BenRufenacht/KosmoKassutronicsQuantizer/QuantizerPanelGraphics.png

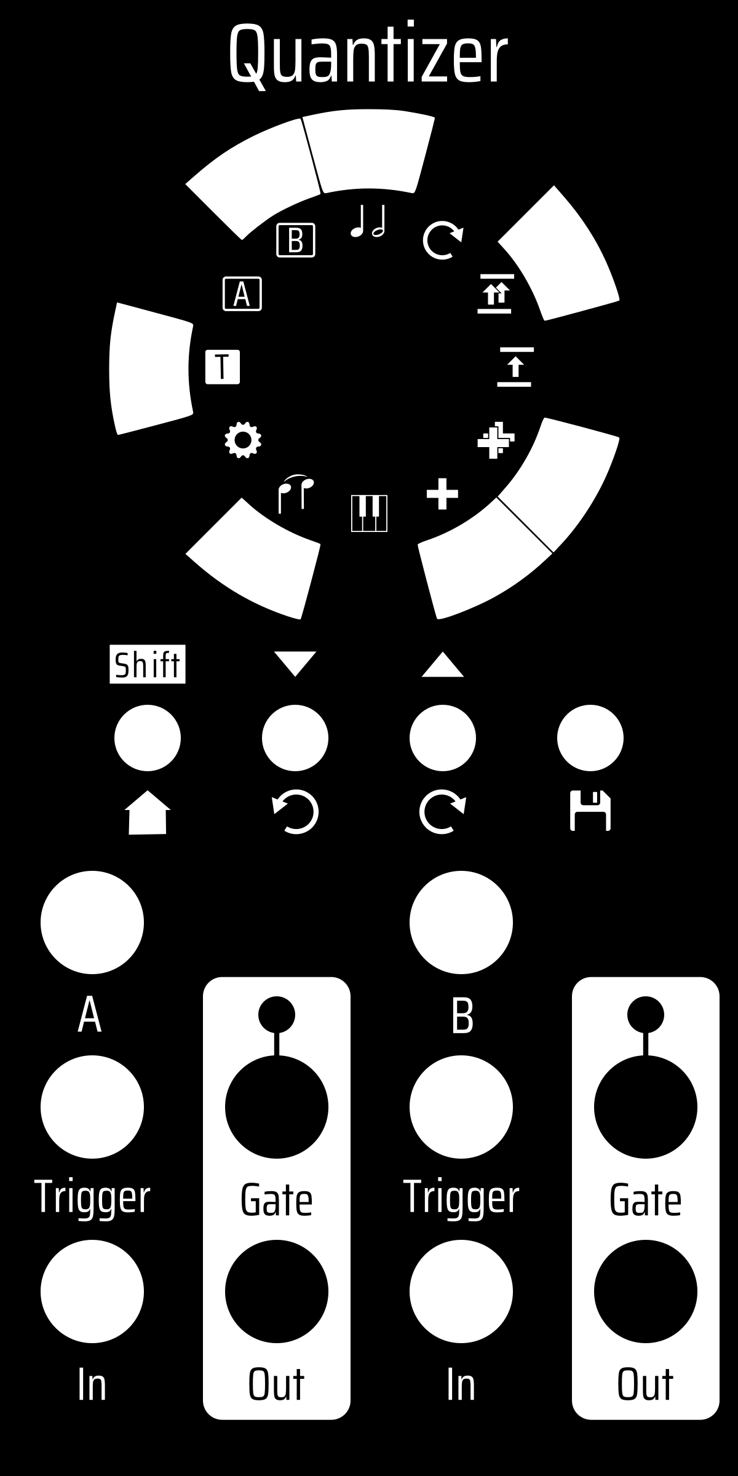
QuantizerPanelGraphics.png
