BenRufenacht/KosmoKassutronicsQuantizer/(list of files, drawings)

Other design files:
QuantizerBack/QuantizerBack.dsn
QuantizerFront/QuantizerFront.dsn
