BenRufenacht/KosmoKassutronicsQuantizer/QuantizerBack/QuantizerBack.kicad_pcb

## KiCad design QuantizerBack/QuantizerBack.kicad_pcb (2023-10-14)

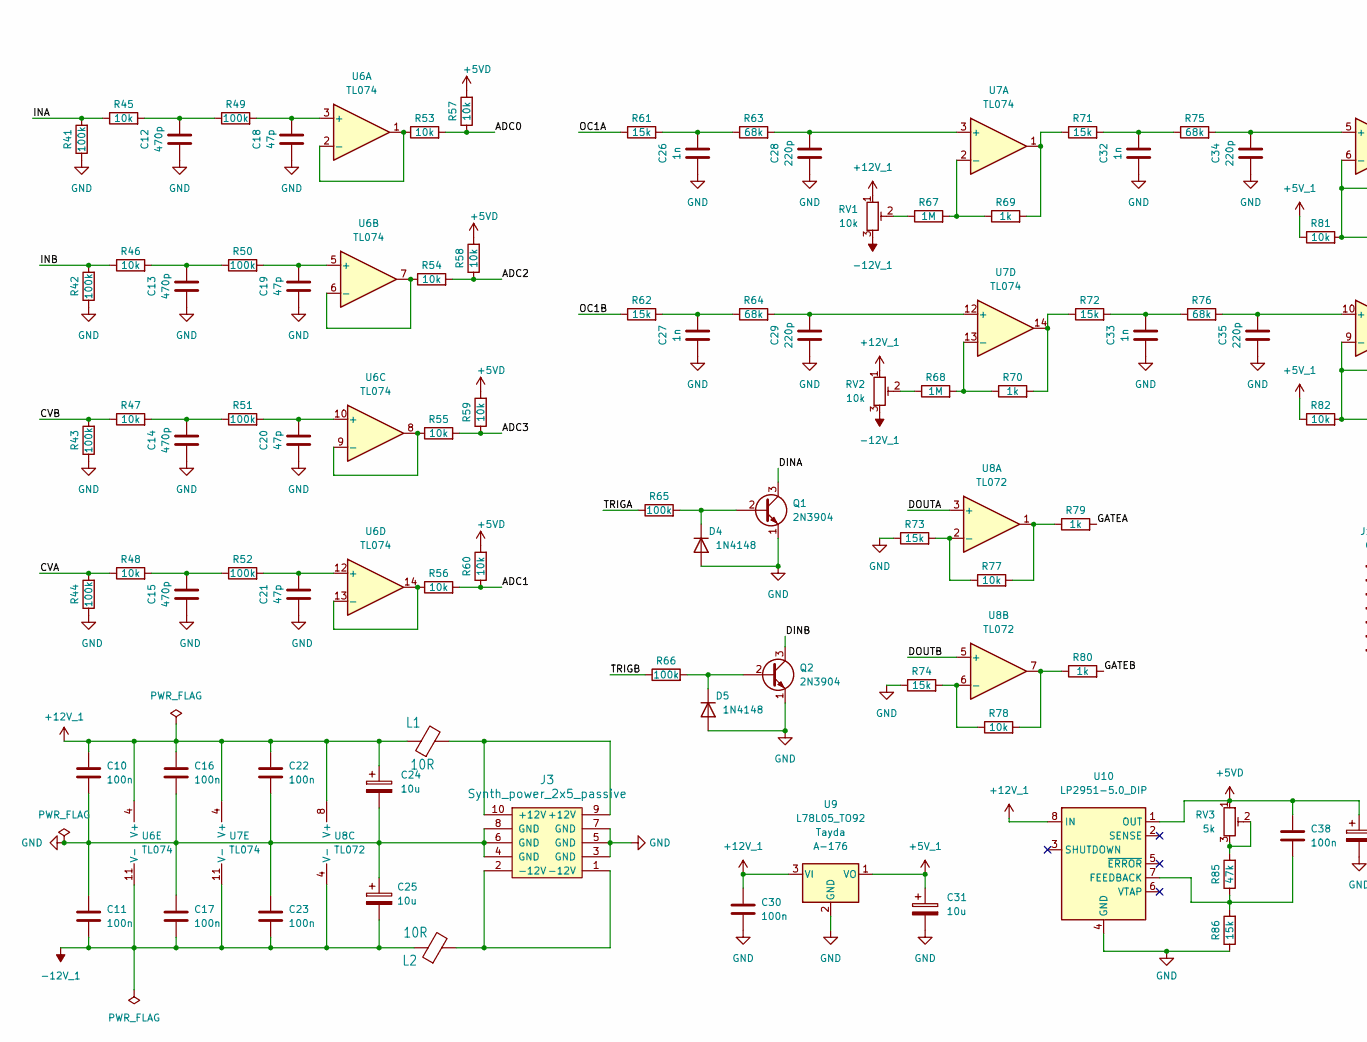
[picture p3: schematic QuantizerBack.kicad_sch, part in row 1, column 1]

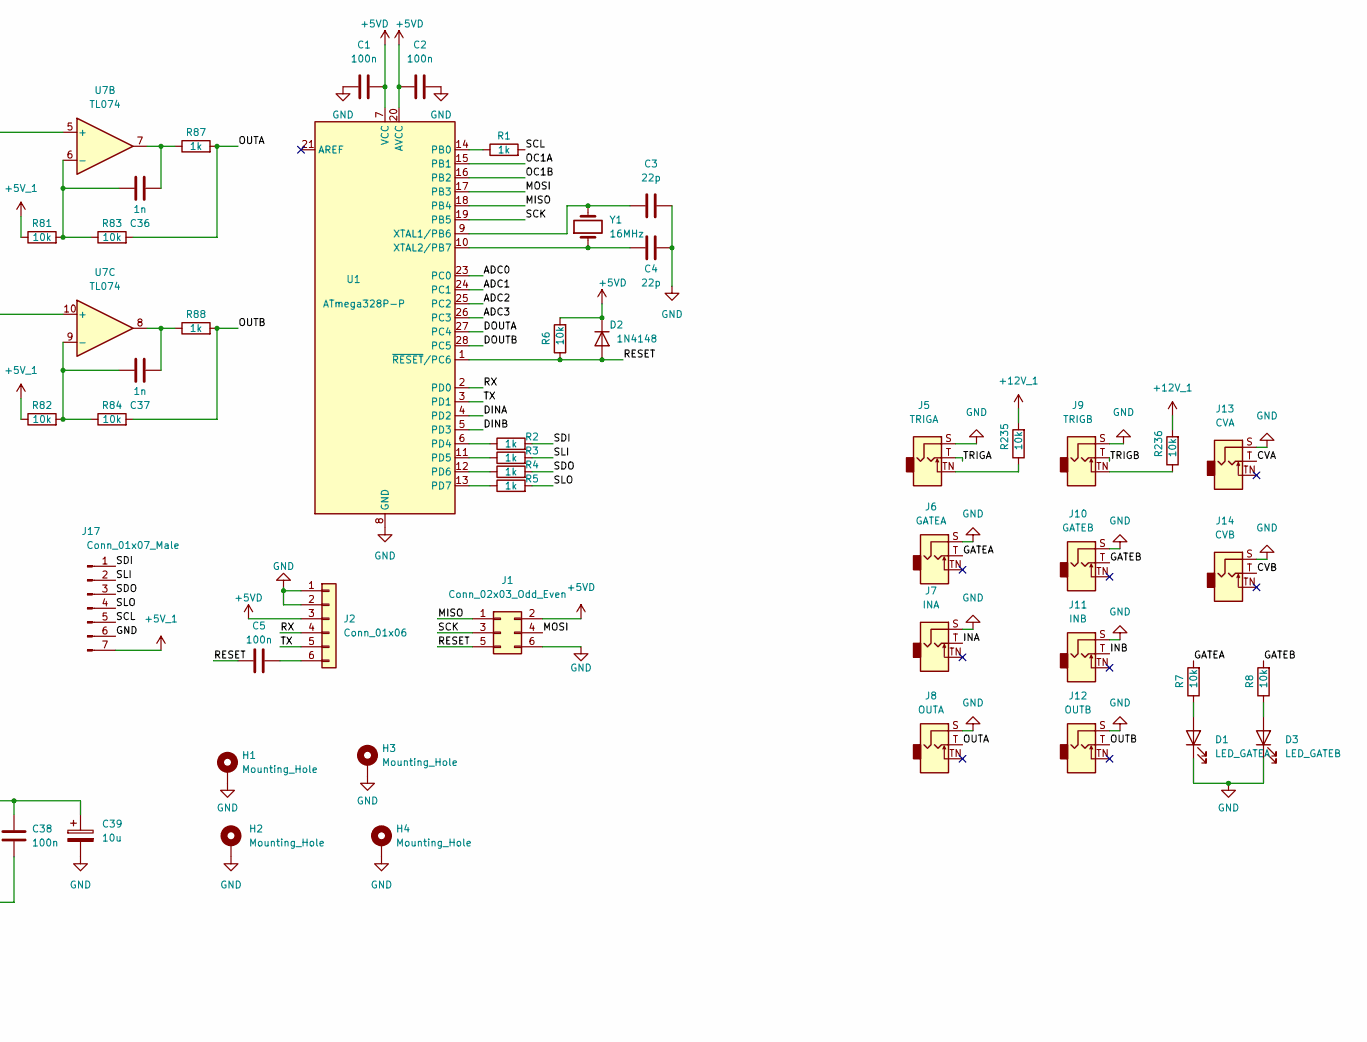
[picture p4: schematic QuantizerBack.kicad_sch, part in row 1, column 2]

Parts:
C1, C2, C5, C10, C11, C16, C17, C22, C23, C30, C38: 100n; C_Rect_L7.2mm_W2.5mm_P5.00mm_FKS2_FKP2_MKS2_MKP2
C3, C4: 22p; C_Rect_L7.2mm_W2.5mm_P5.00mm_FKS2_FKP2_MKS2_MKP2
C12, C13, C14, C15: 470p; C_Rect_L7.2mm_W2.5mm_P5.00mm_FKS2_FKP2_MKS2_MKP2
C18, C19, C20, C21: 47p; C_Rect_L7.2mm_W2.5mm_P5.00mm_FKS2_FKP2_MKS2_MKP2
C24, C25, C31, C39: 10u; CP_Radial_D6.3mm_P2.50mm
C26, C27, C32, C33, C36, C37: 1n; C_Rect_L7.2mm_W2.5mm_P5.00mm_FKS2_FKP2_MKS2_MKP2
C28, C29, C34, C35: 220p; C_Rect_L7.2mm_W2.5mm_P5.00mm_FKS2_FKP2_MKS2_MKP2
D1: LED_GATEA; LED_D5.0mm
D2, D4, D5: 1N4148; D_DO-35_SOD27_P7.62mm_Horizontal
D3: LED_GATEB; LED_D5.0mm
H1, H2, H3, H4: Mounting_Hole; Kosmo_Panel_Mounting_Hole
J1: Conn_02x03_Odd_Even; PinHeader_2x03_P2.54mm_Vertical
J2: Conn_01x06; PinHeader_1x06_P2.54mm_Vertical
J3: Synth_power_2x5_passive; Power_Header
J5: TRIGA; Jack_6.35mm_PJ_629HAN
J6: GATEA; Jack_6.35mm_PJ_629HAN
J7: INA; Jack_6.35mm_PJ_629HAN
J8: OUTA; Jack_6.35mm_PJ_629HAN
J9: TRIGB; Jack_6.35mm_PJ_629HAN
J10: GATEB; Jack_6.35mm_PJ_629HAN
J11: INB; Jack_6.35mm_PJ_629HAN
J12: OUTB; Jack_6.35mm_PJ_629HAN
J13: CVA; Jack_6.35mm_PJ_629HAN
J14: CVB; Jack_6.35mm_PJ_629HAN
J17: Conn_01x07_Male; PinHeader_1x07_P2.54mm_Vertical
L1, L2: 10R; L_Axial_L5.0mm_D3.6mm_P10.00mm_Horizontal_Murata_BL01RN1A2A2
Q1, Q2: 2N3904; TO-92_Inline_Wide
R1, R2, R3, R4, R5, R69, R70, R79, R80, R87, R88: 1k; R_Axial_DIN0207_L6.3mm_D2.5mm_P10.16mm_Horizontal
R6, R7, R8, R45, R46, R47, R48, R53, R54, R55, R56, R57, R58, R59, R60, R77, R78, R81, R82, R83, R84, R235, R236: 10k; R_Axial_DIN0207_L6.3mm_D2.5mm_P10.16mm_Horizontal
R41, R42, R43, R44, R49, R50, R51, R52, R65, R66: 100k; R_Axial_DIN0207_L6.3mm_D2.5mm_P10.16mm_Horizontal
R61, R62, R71, R72, R73, R74, R86: 15k; R_Axial_DIN0207_L6.3mm_D2.5mm_P10.16mm_Horizontal
R63, R64, R75, R76: 68k; R_Axial_DIN0207_L6.3mm_D2.5mm_P10.16mm_Horizontal
R67, R68: 1M; R_Axial_DIN0207_L6.3mm_D2.5mm_P10.16mm_Horizontal
R85: 47k; R_Axial_DIN0207_L6.3mm_D2.5mm_P10.16mm_Horizontal
RV1, RV2: 10k; Potentiometer_Bourns_3296W_Vertical_standard
RV3: 5k; Potentiometer_Bourns_3296W_Vertical_standard
U1: ATmega328P-P; DIP-28_W7.62mm
U6, U7: TL074; DIP-14_W7.62mm_Socket_LongPads
U8: TL072; DIP-8_W7.62mm_Socket_LongPads
U9: L78L05_TO92; TO-92_Inline
U10: LP2951-5.0_DIP; DIP-8_W7.62mm
Y1: 16MHz; Crystal_HC49-U_Vertical

Connections:
+5VD: C1.2, C2.1, C38.1, C39.1, D2.1 (K), J1.2, J2.3, R6.2, R57.2, R58.2, R59.2, R60.2, RV3.1, U1.7 (VCC), U1.20 (AVCC), U10.1 (OUT)
+5V_1: C31.1, J17.7, R81.1, R82.1, U9.1 (VO)
+12V_1: C10.1, C16.1, C22.1, C24.1, C30.1, L1.1, R235.2, R236.2, RV1.1, RV2.1, U6.4 (V+), U7.4 (V+), U8.8 (V+), U9.3 (VI), U10.8 (IN)
-12V_1: C11.1, C17.1, C23.1, C25.2, L2.1, RV1.3, RV2.3, U6.11 (V-), U7.11 (V-), U8.4 (V-)
/ADC0: R53.2, R57.1, U1.23 (PC0)
/ADC1: R56.2, R60.1, U1.24 (PC1)
/ADC2: R54.2, R58.1, U1.25 (PC2)
/ADC3: R55.2, R59.1, U1.26 (PC3)
/CVA: J13.T, R44.2, R48.1
/CVB: J14.T, R43.2, R47.1
/DINA: Q1.3 (C), U1.4 (PD2)
/DINB: Q2.3 (C), U1.5 (PD3)
/DOUTA: U1.27 (PC4), U8.3 (+)
/DOUTB: U1.28 (PC5), U8.5 (+)
/GATEA: J6.T, R7.2, R79.2
/GATEB: J10.T, R8.2, R80.2
/INA: J7.T, R41.2, R45.1
/INB: J11.T, R42.2, R46.1
/MISO: J1.1, U1.18 (PB4)
/MOSI: J1.4, U1.17 (PB3)
/OC1A: R61.1, U1.15 (PB1)
/OC1B: R62.1, U1.16 (PB2)
/OUTA: J8.T, R83.2, R87.2
/OUTB: J12.T, R84.2, R88.2
/RESET: C5.1, D2.2 (A), J1.5, R6.1, U1.1 (~RESET/PC6)
/RX: J2.4, U1.2 (PD0)
/SCK: J1.3, U1.19 (PB5)
/SCL: J17.5, R1.2
/SDI: J17.1, R2.2
/SDO: J17.3, R4.2
/SLI: J17.2, R3.2
/SLO: J17.4, R5.2
/TRIGA: J5.T, R65.1
/TRIGB: J9.T, R66.1
/TX: J2.5, U1.3 (PD1)
GND: C1.1, C2.2, C3.2, C4.2, C10.2, C11.2, C12.1, C13.1, C14.1, C15.1, C16.2, C17.2, C18.1, C19.1, C20.1, C21.1, C22.2, C23.2, C24.2, C25.1, C26.1, C27.1, C28.1, C29.1, C30.2, C31.2, C32.1, C33.1, C34.1, C35.1, C39.2, D1.1 (K), D3.1 (K), D4.2 (A), D5.2 (A), H1.1, H2.1, H3.1, H4.1, J1.6, J2.1, J2.2, J3.3 (GND), J3.4 (GND), J3.5 (GND), J3.6 (GND), J3.7 (GND), J3.8 (GND), J5.S, J6.S, J7.S, J8.S, J9.S, J10.S, J11.S, J12.S, J13.S, J14.S, J17.6, Q1.1 (E), Q2.1 (E), R41.1, R42.1, R43.1, R44.1, R73.1, R74.1, R86.1, U1.8 (GND), U1.22 (GND), U9.2 (GND), U10.4 (GND)
unnamed: C12.2, R45.2, R49.1
unnamed: C13.2, R46.2, R50.1
unnamed: C14.2, R47.2, R51.1
unnamed: C15.2, R48.2, R52.1
unnamed: C26.2, R61.2, R63.1
unnamed: C27.2, R62.2, R64.1
unnamed: C32.2, R71.2, R75.1
unnamed: C33.2, R72.2, R76.1
unnamed: C36.1, R87.1, U7.7
unnamed: C37.1, R88.1, U7.8
unnamed: D1.2 (A), R7.1
unnamed: D3.2 (A), R8.1
unnamed: D4.1 (K), Q1.2 (B), R65.2
unnamed: D5.1 (K), Q2.2 (B), R66.2
unnamed: C5.2, J2.6
unnamed: J3.9 (+12V), J3.10 (+12V), L1.2
unnamed: J3.1 (-12V), J3.2 (-12V), L2.2
unnamed: J5.TN, R235.1
unnamed: J9.TN, R236.1
unnamed: R67.1, RV1.2
unnamed: R68.1, RV2.2
unnamed: R69.2, R71.1, U7.1
unnamed: R70.2, R72.1, U7.14
unnamed: R77.2, R79.1, U8.1
unnamed: R78.2, R80.1, U8.7
unnamed: R85.2, RV3.2, RV3.3
unnamed: R1.1, U1.14 (PB0)
unnamed: R2.1, U1.6 (PD4)
unnamed: R3.1, U1.11 (PD5)
unnamed: R4.1, U1.12 (PD6)
unnamed: R5.1, U1.13 (PD7)
unnamed: C3.1, U1.9 (XTAL1/PB6), Y1.2
unnamed: C4.1, U1.10 (XTAL2/PB7), Y1.1
unnamed: C18.2, R49.2, U6.3 (+)
unnamed: R53.1, U6.1, U6.2 (-)
unnamed: C19.2, R50.2, U6.5 (+)
unnamed: R54.1, U6.6 (-), U6.7
unnamed: C20.2, R51.2, U6.10 (+)
unnamed: R55.1, U6.8, U6.9 (-)
unnamed: C21.2, R52.2, U6.12 (+)
unnamed: R56.1, U6.13 (-), U6.14
unnamed: C28.2, R63.2, U7.3 (+)
unnamed: R67.2, R69.1, U7.2 (-)
unnamed: C34.2, R75.2, U7.5 (+)
unnamed: C36.2, R81.2, R83.1, U7.6 (-)
unnamed: C35.2, R76.2, U7.10 (+)
unnamed: C37.2, R82.2, R84.1, U7.9 (-)
unnamed: C29.2, R64.2, U7.12 (+)
unnamed: R68.2, R70.1, U7.13 (-)
unnamed: R73.2, R77.1, U8.2 (-)
unnamed: R74.2, R78.1, U8.6 (-)
unnamed: C38.2, R85.1, R86.2, U10.7 (FEEDBACK)

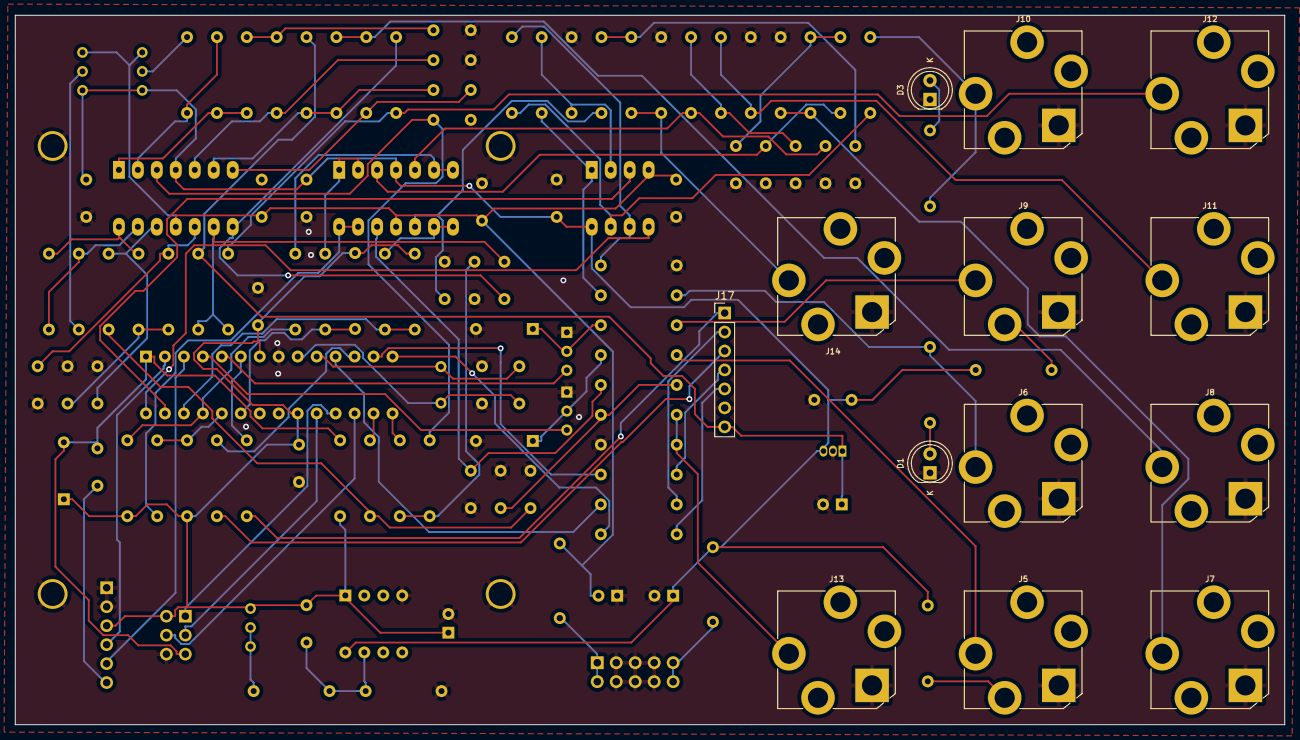
[picture p5: board QuantizerBack.kicad_pcb from above]

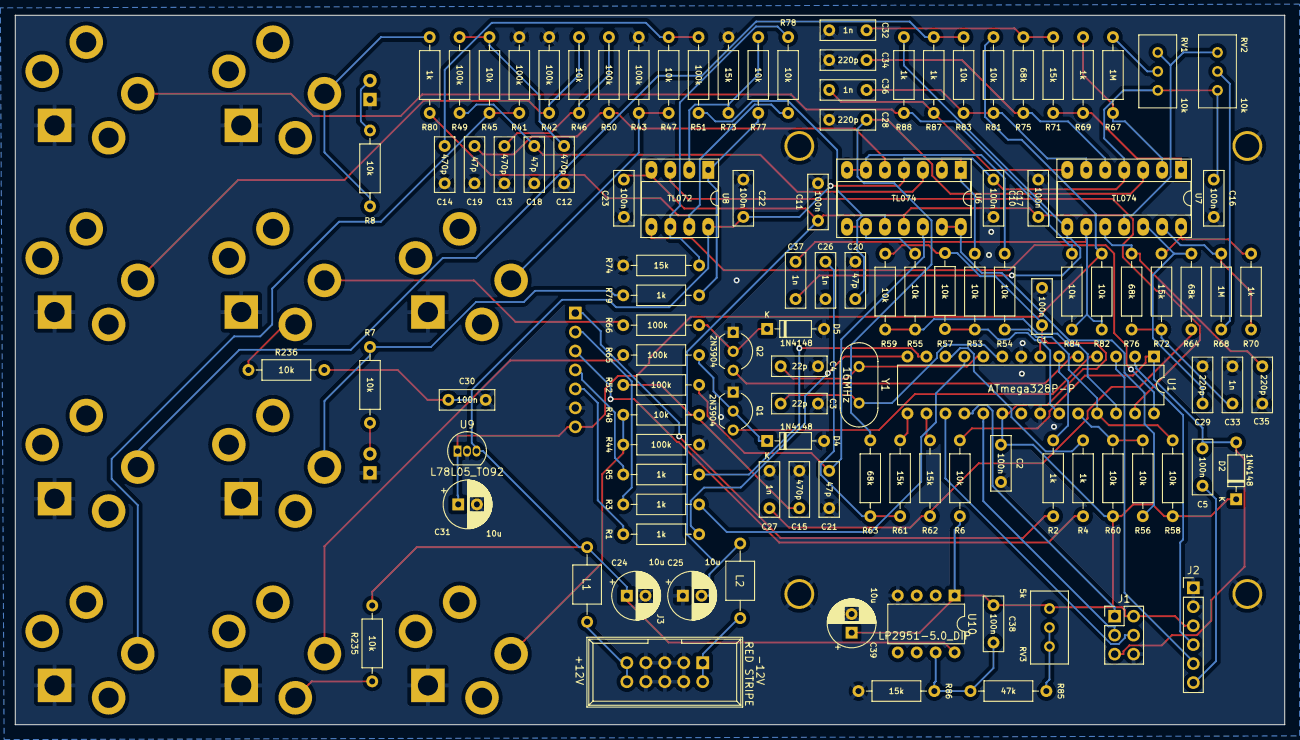
[picture p6: board QuantizerBack.kicad_pcb from below]

Board: 2 copper layers, 170.0 x 95.0 mm, 130 parts (113 on the bottom side), 88 nets.
