BenRufenacht/KosmoKassutronicsQuantizer/QuantizerFront/QuantizerFront.kicad_pcb

## KiCad design QuantizerFront/QuantizerFront.kicad_pcb (2022-07-14)

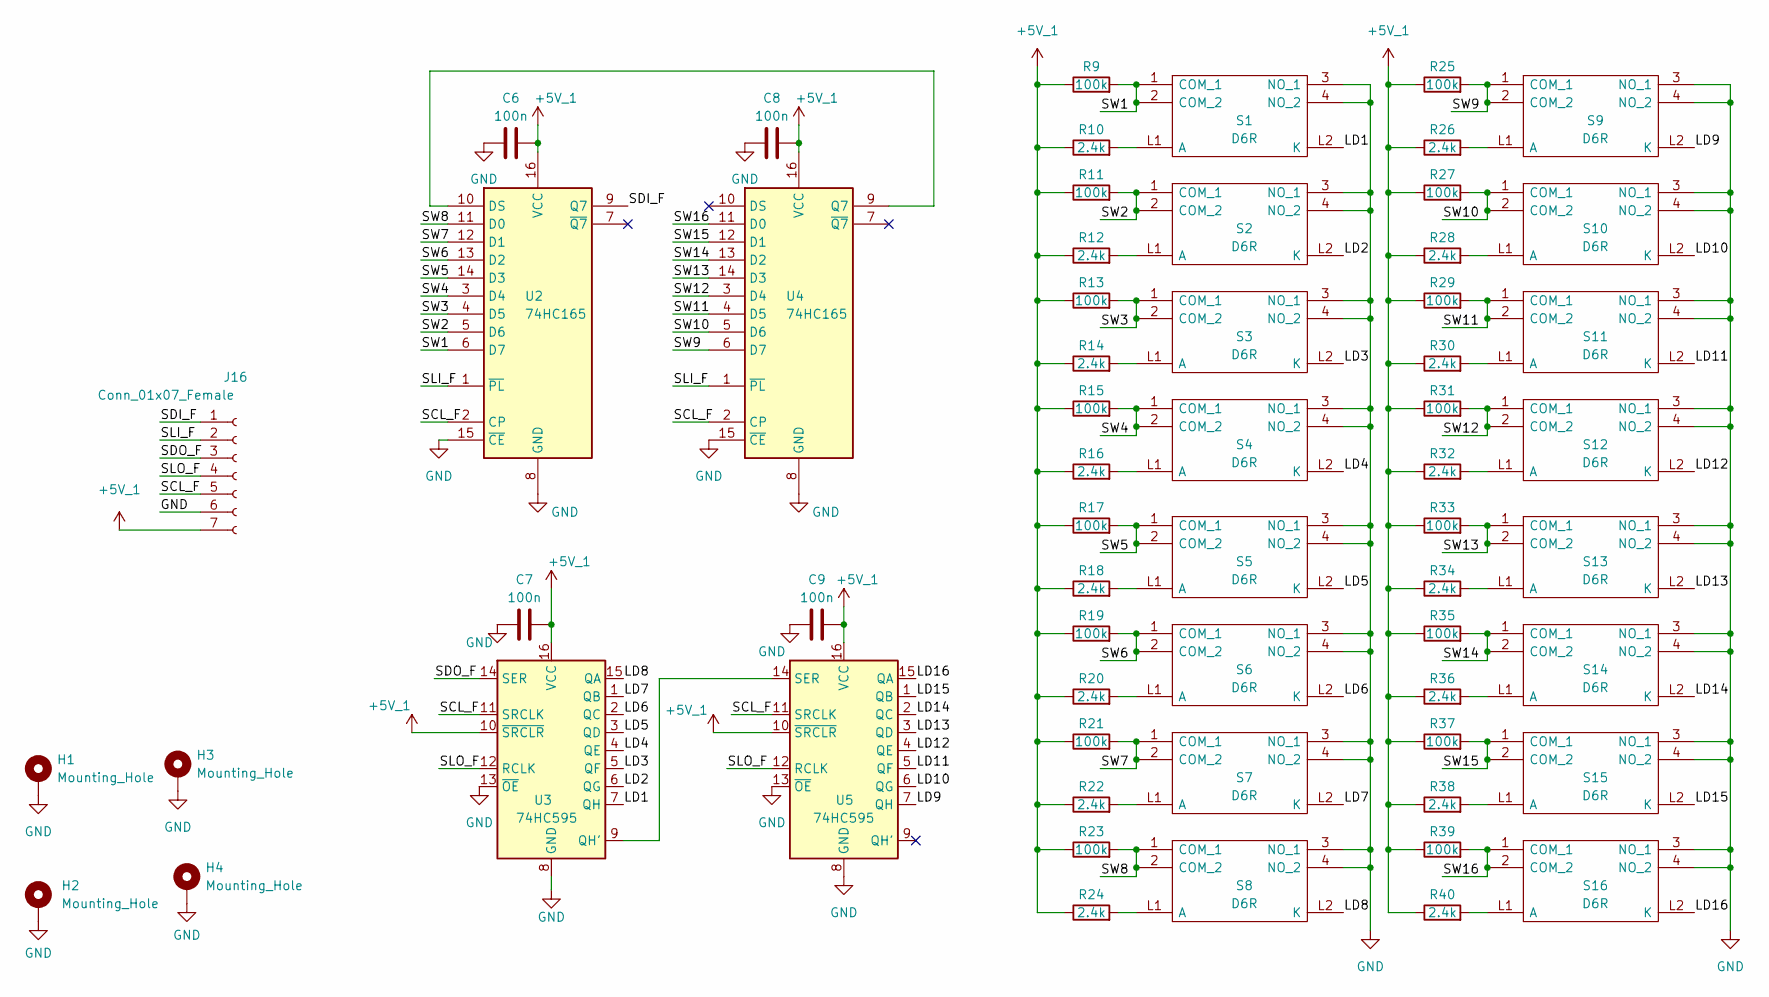
[picture p7: schematic QuantizerFront.kicad_sch]

Parts:
C6, C7, C8, C9: 100n; C_Rect_L7.2mm_W2.5mm_P5.00mm_FKS2_FKP2_MKS2_MKP2
H1, H2, H3, H4: Mounting_Hole; Kosmo_Panel_Mounting_Hole
J16: Conn_01x07_Female; PinSocket_1x07_P2.54mm_Vertical
R9, R11, R13, R15, R17, R19, R21, R23, R25, R27, R29, R31, R33, R35, R37, R39: 100k; R_Axial_DIN0207_L6.3mm_D2.5mm_P10.16mm_Horizontal
R10, R12, R14, R16, R18, R20, R22, R24, R26, R28, R30, R32, R34, R36, R38, R40: 2.4k; R_Axial_DIN0207_L6.3mm_D2.5mm_P10.16mm_Horizontal
S1, S2, S3, S4, S5, S6, S7, S8, S9, S10, S11, S12, S13, S14, S15, S16: D6R; Manufacturer_Part_Number D6RLGNF1+LFS
U2, U4: 74HC165; DIP-16_W7.62mm_Socket_LongPads
U3, U5: 74HC595; DIP-16_W7.62mm_Socket_LongPads

Connections:
+5V_1: C6.2, C7.2, C8.2, C9.2, J16.7, R9.1, R10.1, R11.1, R12.1, R13.1, R14.1, R15.1, R16.1, R17.1, R18.1, R19.1, R20.1, R21.1, R22.1, R23.1, R24.1, R25.1, R26.1, R27.1, R28.1, R29.1, R30.1, R31.1, R32.1, R33.1, R34.1, R35.1, R36.1, R37.1, R38.1, R39.1, R40.1, U2.16 (VCC), U3.10 (~SRCLR), U3.16 (VCC), U4.16 (VCC), U5.10 (~SRCLR), U5.16 (VCC)
/LD1: S1.L2 (K), U3.7 (QH)
/LD2: S2.L2 (K), U3.6 (QG)
/LD3: S3.L2 (K), U3.5 (QF)
/LD4: S4.L2 (K), U3.4 (QE)
/LD5: S5.L2 (K), U3.3 (QD)
/LD6: S6.L2 (K), U3.2 (QC)
/LD7: S7.L2 (K), U3.1 (QB)
/LD8: S8.L2 (K), U3.15 (QA)
/LD9: S9.L2 (K), U5.7 (QH)
/LD10: S10.L2 (K), U5.6 (QG)
/LD11: S11.L2 (K), U5.5 (QF)
/LD12: S12.L2 (K), U5.4 (QE)
/LD13: S13.L2 (K), U5.3 (QD)
/LD14: S14.L2 (K), U5.2 (QC)
/LD15: S15.L2 (K), U5.1 (QB)
/LD16: S16.L2 (K), U5.15 (QA)
/SCL_F: J16.5, U2.2 (CP), U3.11 (SRCLK), U4.2 (CP), U5.11 (SRCLK)
/SDI_F: J16.1, U2.9 (Q7)
/SDO_F: J16.3, U3.14 (SER)
/SLI_F: J16.2, U2.1 (~PL), U4.1 (~PL)
/SLO_F: J16.4, U3.12 (RCLK), U5.12 (RCLK)
/SW1: R9.2, S1.1 (COM_1), S1.2 (COM_2), U2.6 (D7)
/SW2: R11.2, S2.1 (COM_1), S2.2 (COM_2), U2.5 (D6)
/SW3: R13.2, S3.1 (COM_1), S3.2 (COM_2), U2.4 (D5)
/SW4: R15.2, S4.1 (COM_1), S4.2 (COM_2), U2.3 (D4)
/SW5: R17.2, S5.1 (COM_1), S5.2 (COM_2), U2.14 (D3)
/SW6: R19.2, S6.1 (COM_1), S6.2 (COM_2), U2.13 (D2)
/SW7: R21.2, S7.1 (COM_1), S7.2 (COM_2), U2.12 (D1)
/SW8: R23.2, S8.1 (COM_1), S8.2 (COM_2), U2.11 (D0)
/SW9: R25.2, S9.1 (COM_1), S9.2 (COM_2), U4.6 (D7)
/SW10: R27.2, S10.1 (COM_1), S10.2 (COM_2), U4.5 (D6)
/SW11: R29.2, S11.1 (COM_1), S11.2 (COM_2), U4.4 (D5)
/SW12: R31.2, S12.1 (COM_1), S12.2 (COM_2), U4.3 (D4)
/SW13: R33.2, S13.1 (COM_1), S13.2 (COM_2), U4.14 (D3)
/SW14: R35.2, S14.1 (COM_1), S14.2 (COM_2), U4.13 (D2)
/SW15: R37.2, S15.1 (COM_1), S15.2 (COM_2), U4.12 (D1)
/SW16: R39.2, S16.1 (COM_1), S16.2 (COM_2), U4.11 (D0)
GND: C6.1, C7.1, C8.1, C9.1, H1.1, H2.1, H3.1, H4.1, J16.6, S1.3 (NO_1), S1.4 (NO_2), S2.3 (NO_1), S2.4 (NO_2), S3.3 (NO_1), S3.4 (NO_2), S4.3 (NO_1), S4.4 (NO_2), S5.3 (NO_1), S5.4 (NO_2), S6.3 (NO_1), S6.4 (NO_2), S7.3 (NO_1), S7.4 (NO_2), S8.3 (NO_1), S8.4 (NO_2), S9.3 (NO_1), S9.4 (NO_2), S10.3 (NO_1), S10.4 (NO_2), S11.3 (NO_1), S11.4 (NO_2), S12.3 (NO_1), S12.4 (NO_2), S13.3 (NO_1), S13.4 (NO_2), S14.3 (NO_1), S14.4 (NO_2), S15.3 (NO_1), S15.4 (NO_2), S16.3 (NO_1), S16.4 (NO_2), U2.8 (GND), U2.15 (~CE), U3.8 (GND), U3.13 (~OE), U4.8 (GND), U4.15 (~CE), U5.8 (GND), U5.13 (~OE)
unnamed: R10.2, S1.L1 (A)
unnamed: R12.2, S2.L1 (A)
unnamed: R14.2, S3.L1 (A)
unnamed: R16.2, S4.L1 (A)
unnamed: R18.2, S5.L1 (A)
unnamed: R20.2, S6.L1 (A)
unnamed: R22.2, S7.L1 (A)
unnamed: R24.2, S8.L1 (A)
unnamed: R26.2, S9.L1 (A)
unnamed: R28.2, S10.L1 (A)
unnamed: R30.2, S11.L1 (A)
unnamed: R32.2, S12.L1 (A)
unnamed: R34.2, S13.L1 (A)
unnamed: R36.2, S14.L1 (A)
unnamed: R38.2, S15.L1 (A)
unnamed: R40.2, S16.L1 (A)
unnamed: U2.10 (DS), U4.9 (Q7)
unnamed: U3.9 (QH'), U5.14 (SER)

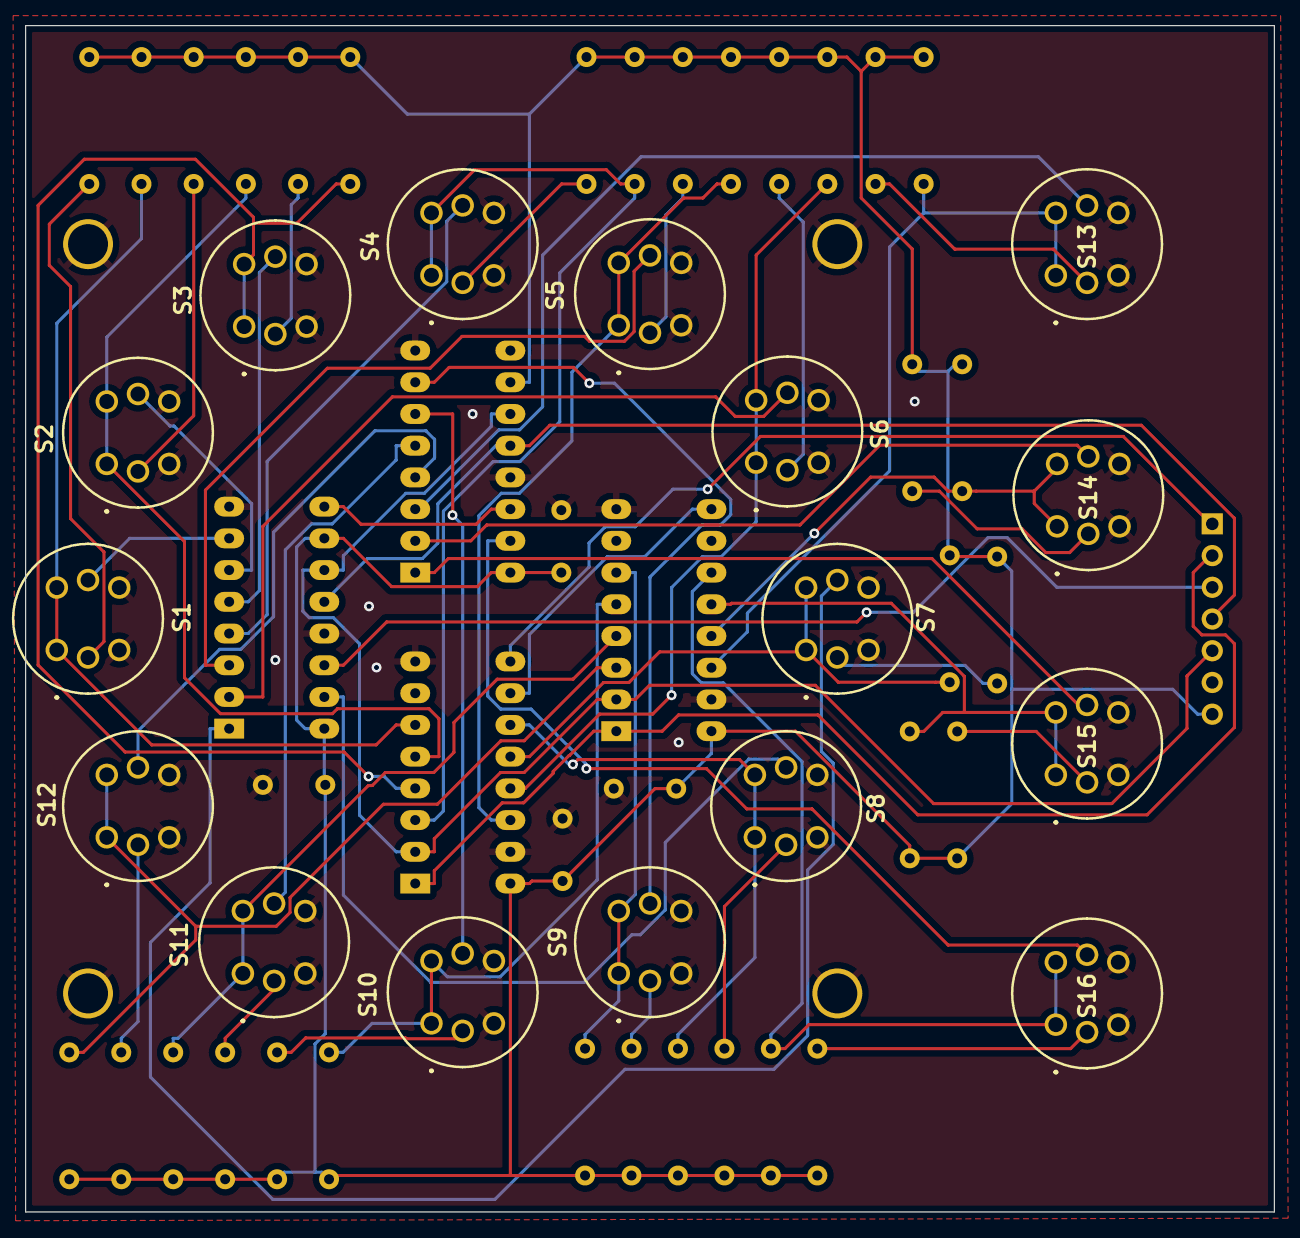
[picture p8: board QuantizerFront.kicad_pcb from above]

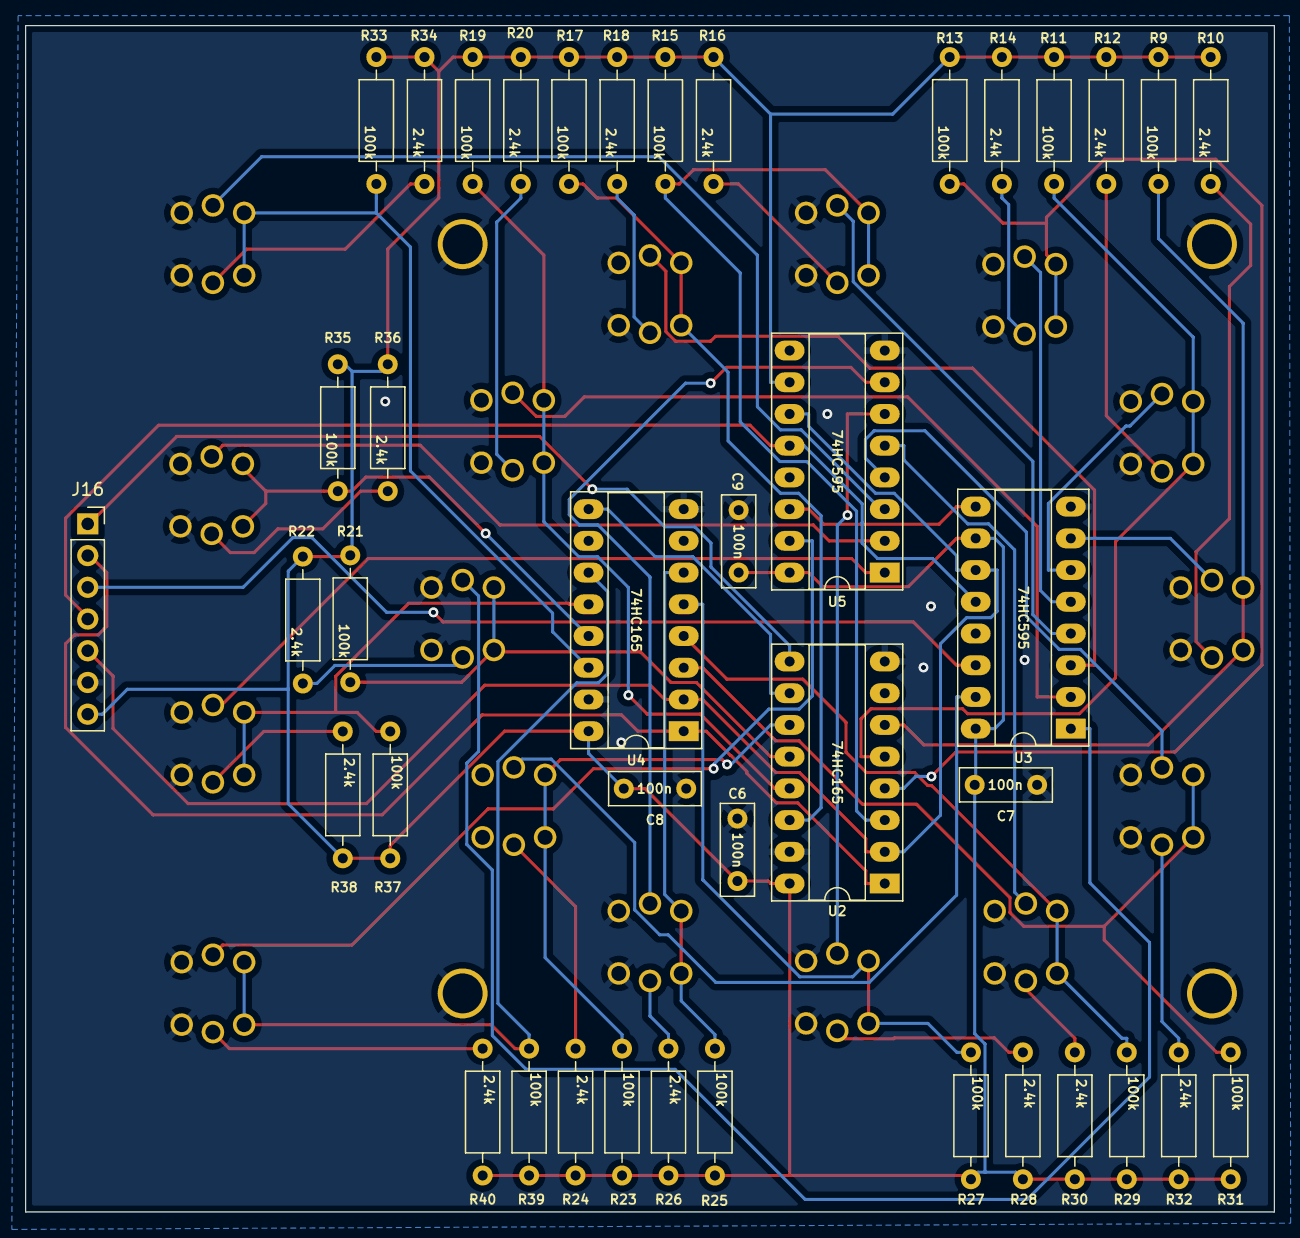
[picture p9: board QuantizerFront.kicad_pcb from below]

Board: 2 copper layers, 100.0 x 95.0 mm, 61 parts (41 on the bottom side), 57 nets.
