BenRufenacht/KosmoKassutronicsQuantizer/(commit log)

2022-07-14 Manufacturing Updates
    [QuantizerBack-B_Cu.gbr, QuantizerBack-B_Mask.gbr, QuantizerBack-B_Paste.gbr, QuantizerBack-B_Silkscreen.gbr, QuantizerBack-Edge_Cuts.gbr, QuantizerBack-F_Cu.gbr, QuantizerBack-F_Mask.gbr, QuantizerBack-F_Paste.gbr]
2022-07-14 Gerber Updates
    [QuantizerFront-B_Cu.gbr, QuantizerFront-B_Mask.gbr, QuantizerFront-B_Paste.gbr, QuantizerFront-B_Silkscreen.gbr, QuantizerFront-Edge_Cuts.gbr, QuantizerFront-F_Cu.gbr, QuantizerFront-F_Mask.gbr, QuantizerFront-F_Paste.gbr]
2023-10-14 Fix Trigger Input Jack Issue
    Previous version of these boards did not have the tip normal of the input jacks connected to +12v to allow free running mode. Kassutronics updated the documentation to add a resistor that prevents shorting in this connection. This update connects the tip normal in the input jacks to +12v through a 10k resistor.
    [QuantizerBack-B_Cu.gbl, QuantizerBack-B_Cu.gbr, QuantizerBack-B_Mask.gbs, QuantizerBack-B_Paste.gbp, QuantizerBack-B_Silkscreen.gbo, QuantizerBack-B_Silkscreen.gbr, QuantizerBack-Edge_Cuts.gm1, QuantizerBack-F_Cu.gbr]
2023-10-14 Update readme
    Update readme to note that the pcb is untested.
